aov-0/termostaatti/Schematic.pdf

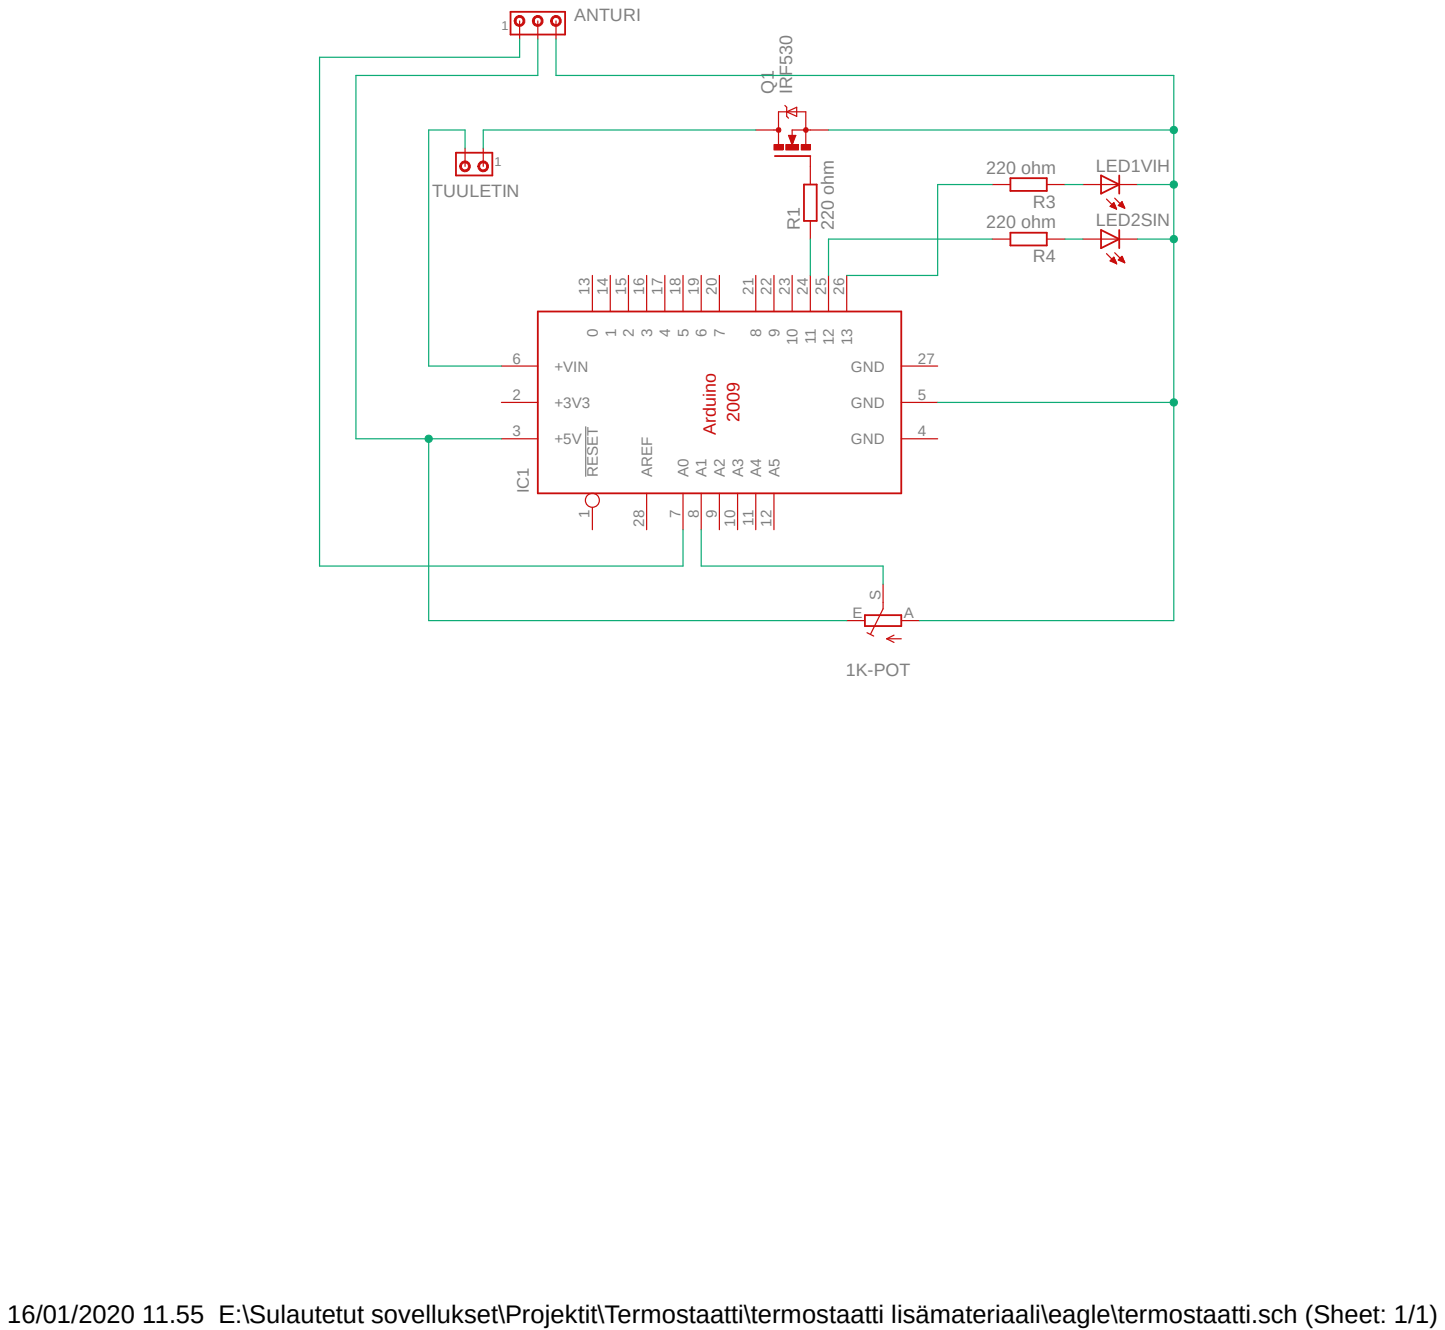
[picture p9: page 1]
16/01/2020 11.55 E:\Sulautetut sovellukset\Projektit\Termostaatti\termostaatti lisämateriaali\eagle\termostaatti.sch (Sheet: 1/1) IRF530; 220 ohm; 220 ohm 13 26 12 25 11 24 10 23; 8 A5 12 RESET; 1 TUULETIN; 1 ANTURI; 1K-POT; LED1VIH; LED2SIN; R4 Arduino 2009

0 13 GND 4 GND 5 GND 27 AREF 28 +5V 3 +3V3 2 +VIN 6 A0
